Liquid-Prep/LiquidPrep-Hardware/CNM/images/BlueFruitHEX.jpg

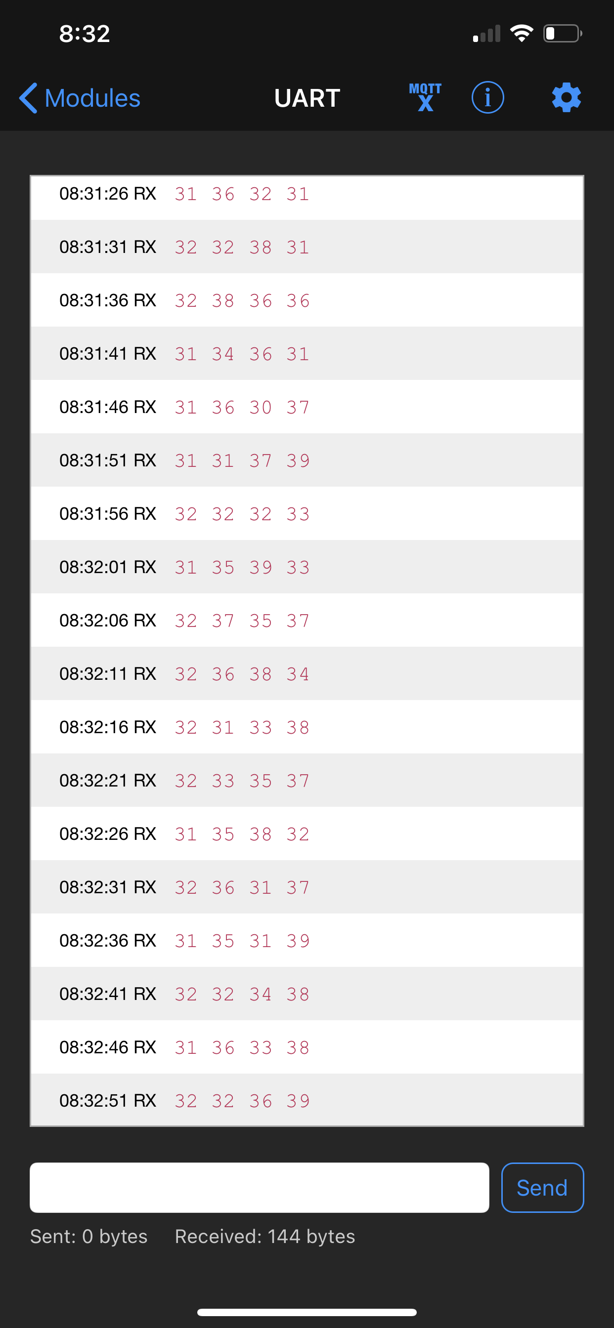
CNM/images/BlueFruitHEX.jpg
