Liquid-Prep/LiquidPrep-Hardware/CNM/images/BluefruitUART.png

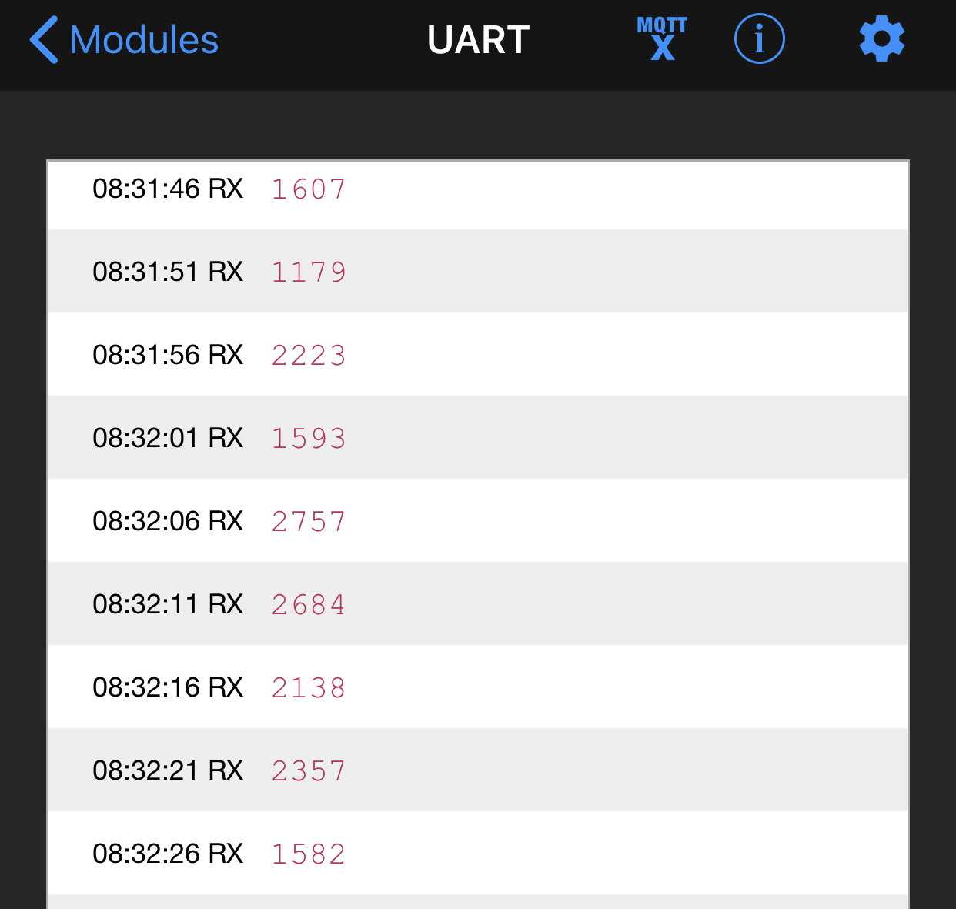
CNM/images/BluefruitUART.png
