Liquid-Prep/LiquidPrep-Hardware/CNM/images/boron.jpg

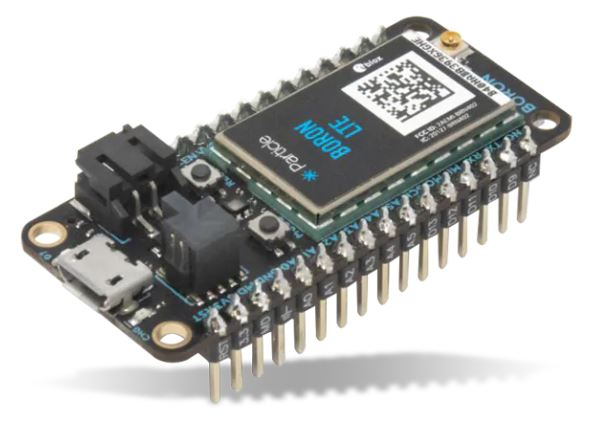
CNM/images/boron.jpg
