Liquid-Prep/LiquidPrep-Hardware/CNM/images/Complie.jpg

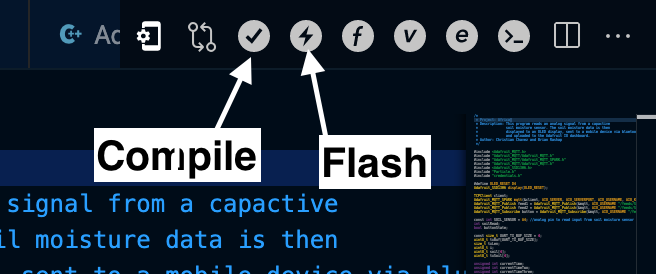
CNM/images/Complie.jpg
