Liquid-Prep/LiquidPrep-Hardware/CNM/images/HardwareLoading.jpg

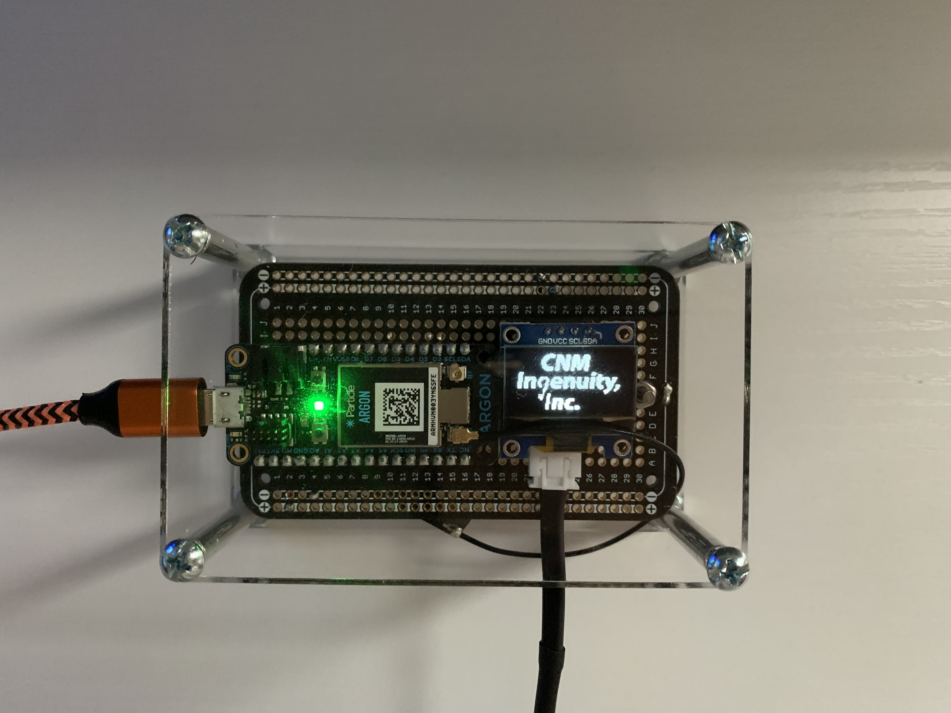
CNM/images/HardwareLoading.jpg
