Liquid-Prep/LiquidPrep-Hardware/CNM/images/MorseCamApp.jpg

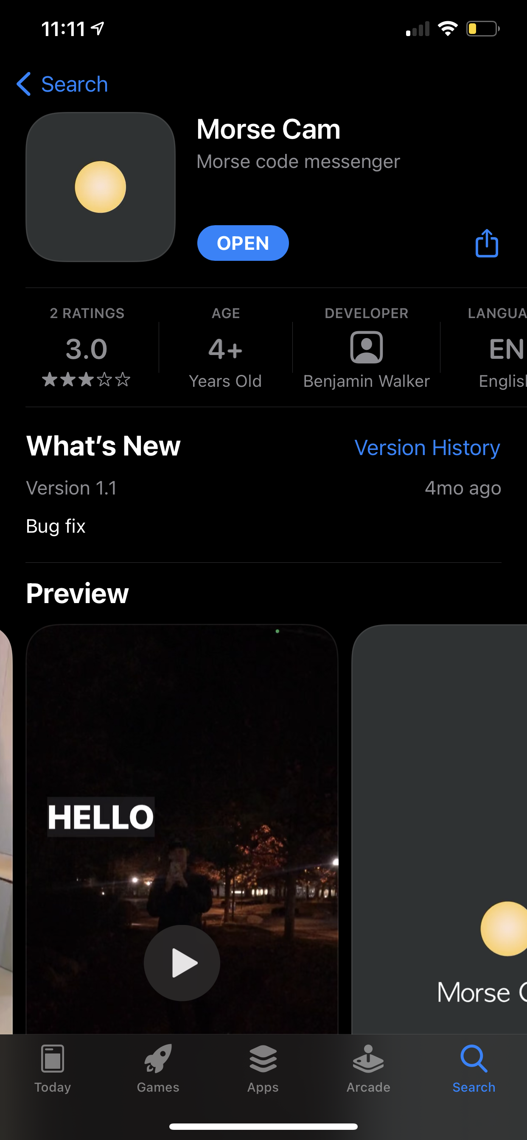
CNM/images/MorseCamApp.jpg
