Liquid-Prep/LiquidPrep-Hardware/CNM/images/ParticleCase.jpg

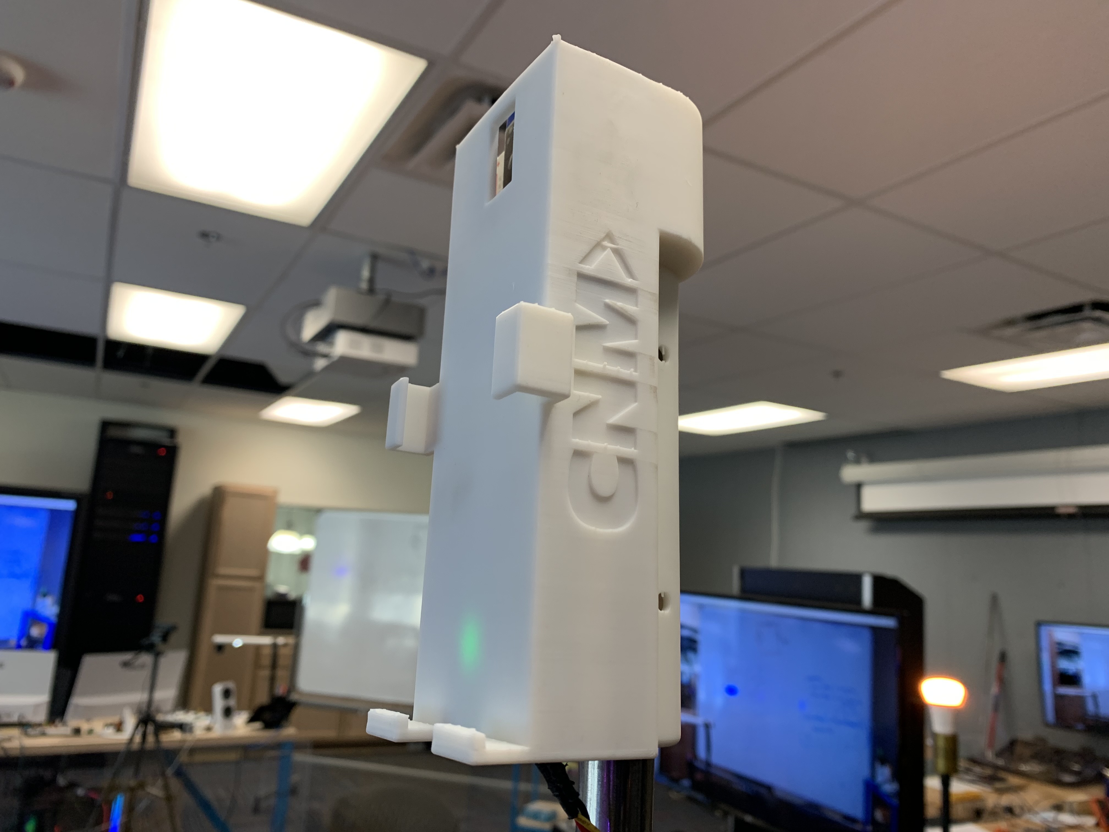
CNM/images/ParticleCase.jpg
