Liquid-Prep/LiquidPrep-Hardware/CNM/images/ProbesWithFuse.jpg

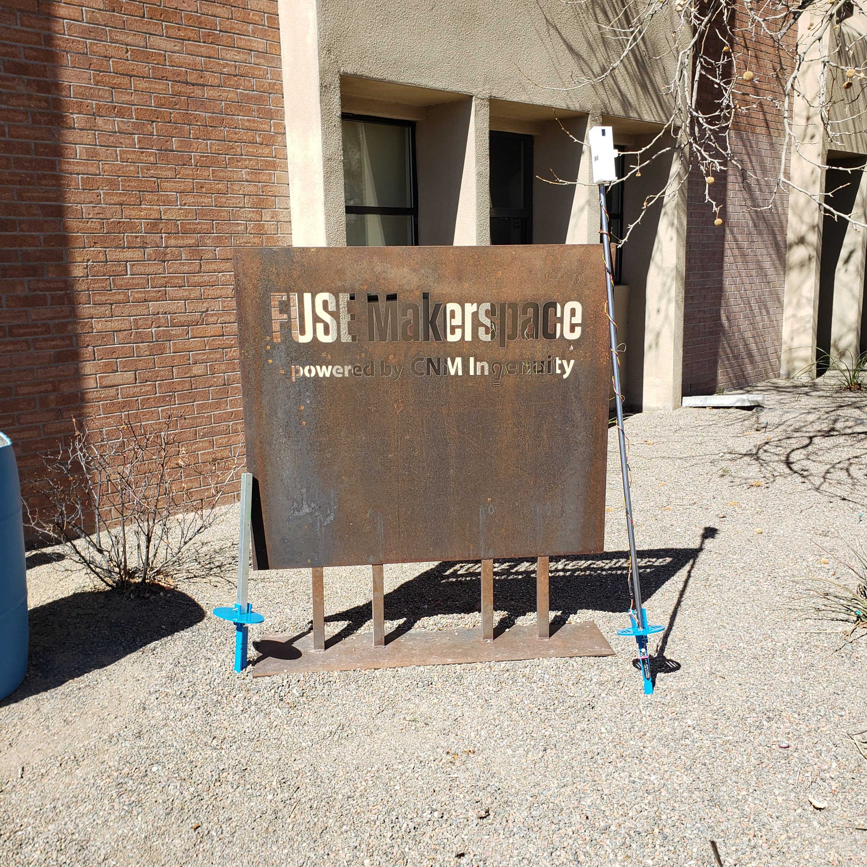
CNM/images/ProbesWithFuse.jpg
