Liquid-Prep/LiquidPrep-Hardware/esp-now/sensors-view.png

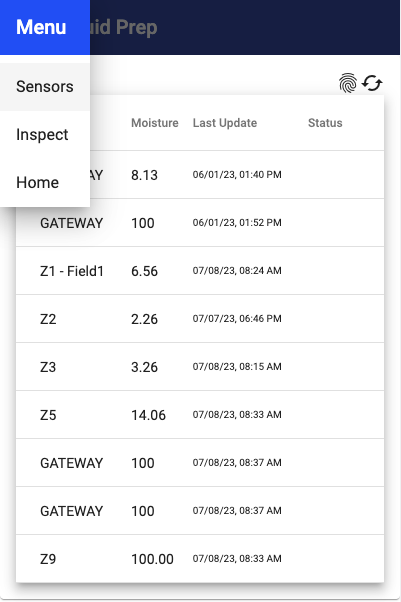
esp-now/sensors-view.png
