Liquid-Prep/LiquidPrep-Hardware/readme-qr.jpg

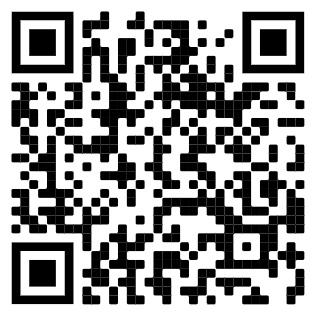
readme-qr.jpg
