Liquid-Prep/LiquidPrep-Hardware/CNM/3D Print/CNMParticleLid.stl

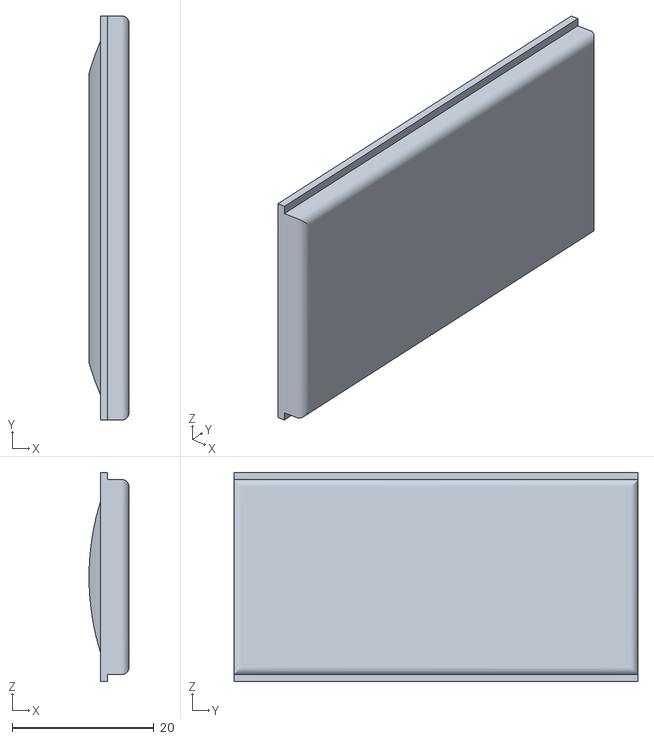
[picture p39: CAD file, 2022-02-01]
CNM/3D Print/CNMParticleLid.stl
5.64 x 57.0 x 29.5
