Liquid-Prep/LiquidPrep-Hardware/CNM/3D Print/CNMParticleCase.stl

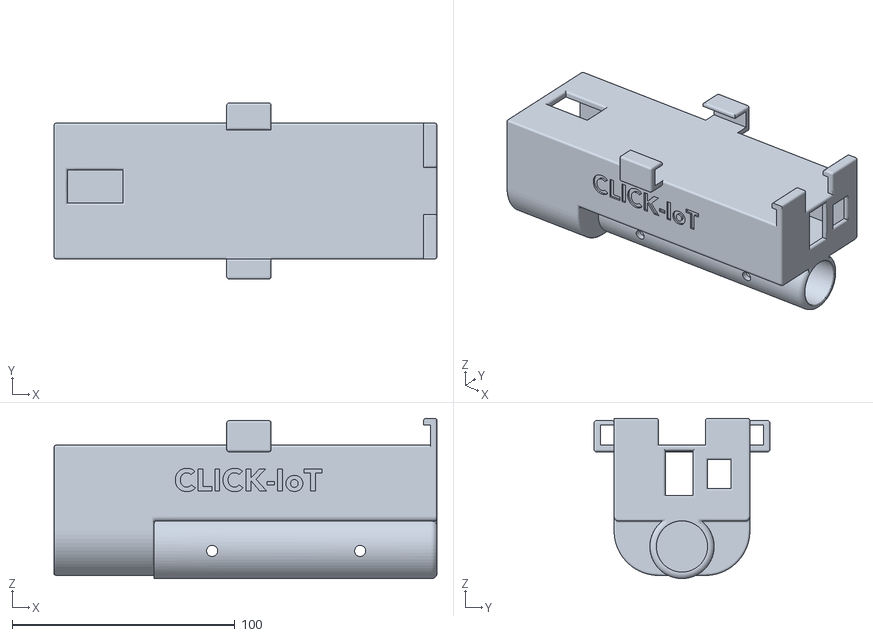
[picture p40: CAD file, 2022-02-01]
CNM/3D Print/CNMParticleCase.stl
172.0 x 79.0 x 71.9
