Liquid-Prep/LiquidPrep-Hardware/esp32-websocket-client/test/notes.txt

#include <ESP8266WiFi.h>
#include <ESP8266WebServer.h>
#include <WebSocketsServer.h>
#include <AutoConnect.h>

ESP8266WebServer server(80);
WebSocketsServer webSocket(81);
AutoConnect      portal(server);
AutoConnectAux   AUX;

void setup() {
  delay(1000);
  Serial.begin(115200);
  Serial.println();

  portal.join({ AUX }); // Join the AutoConnectAux
  if (portal.begin()) { // <--- Should be first.
    webSocket.begin();  // <--- After AutoConnect::begin
    webSocket.onEvent([] (uint8_t num, WStype_t type, uint8_t * payload, size_t length) {
      switch(type) {
      case WStype_DISCONNECTED:
        DEBUG_ESP_PORT.printf("[%u] Disconnected!\n", num);
        break;
      case WStype_CONNECTED: {
        IPAddress ip = webSocket.remoteIP(num);
        DEBUG_ESP_PORT.printf("[%u] Connected from %s\n", num, ip.toString().c_str());
        webSocket.sendTXT(num, "Connected");
        }
        break;
      case WStype_TEXT:
        DEBUG_ESP_PORT.printf("[%u] get Text: %s\n", num, payload);
        // send some response to the client
        // webSocket.sendTXT(num, "message here");
        break;
      }
    });
  }
}

void loop() {
  webSocket.loop();
  portal.handleClient();
}
