Liquid-Prep/LiquidPrep-Hardware/(list of files, drawings)

Other design files:
CNM/Particle Sensor Schematics/CNM Moisture Sensor Fritzing Diagram.fzz
