Liquid-Prep/LiquidPrep-Hardware/Soil Moisture Sensor/src/main.cpp

#include <WebServer.h>
#include <WiFi.h>
#include <WiFiClientSecure.h>
#include <AutoConnect.h>
#include <HTTPClient.h>
#include <Arduino.h>
#include <ArduinoJson.h>
#include <BLEDevice.h>
#include <BLEUtils.h>
#include <BLEServer.h>

#define FIRMWARE_VERSION           "0.2.1";
// See the following for generating UUIDs:
// https://www.uuidgenerator.net/

#define SERVICE_UUID        "4fafc201-1fb5-459e-8fcc-c5c9c331914b"
#define CHARACTERISTIC_UUID "beb5483e-36e1-4688-b7f5-ea07361b26a8"

BLECharacteristic *pCharacteristic;
WebServer Server;
AutoConnect Portal(Server);
AutoConnectConfig Config;
HTTPClient http;
WiFiClientSecure client;
String moistureLevel = "";
int airValue = 3440; //3442;  // enter your max air value here
int waterValue = 1803; //1779;  // enter your water value here
int SensorPin = 32;
int soilMoistureValue = 0;
float soilmoisturepercent=0;
const char* fwVersion = FIRMWARE_VERSION;
StaticJsonDocument<512> doc;

void homePage() {
  String htmlResponse = "";
  String jsonString2 = "";
  char jsonString[300];
  char temp[10];
  unsigned int totalBytes = 0;
  unsigned int usedBytes = 0;
  
  htmlResponse = "<!DOCTYPE html>\
  <html lang=\"en\">\
    <head>\
      <meta charset=\"utf-8\">\
      <meta name=\"viewport\" content=\"width=device-width, initial-scale=1\">\
    </head>\
    <body>\
      <h1>Get moisture reading</h1>\
      <div>\
        <div class=\"moisture_container\">Moisture: </div><br>\
        <button id=\"moisture_button\" class=\"moist\">Get Moisture</button>\
      </div>\
      <h3>Remove wifi</h3>\
      <div>\
        <div class=\"wifi_container\">Wifi: </div><br>\
        <button id=\"wifi_button\" class=\"moist\">Remove Wifi</button>\
      </div>\
      <script src=\"https://ajax.googleapis.com/ajax/libs/jquery/1.11.3/jquery.min.js\"></script>\
      <script>\
        var message;\
        var msg;\
        $('.moist').click(function(e){\
          e.preventDefault();\
          if(e.target.id === 'moisture_button') {\
            msg = 'msg1';\
            message = $('#msg1').val();\
            $.get('/moisture', function(data){\
              $('.moisture_container')[0].innerText = 'Moisture: ' + data + '%';\
              console.log(data);\
            });\
          }\
          else if(e.target.id === 'wifi_button') {\
            $.get('/cancelwifi', function(data){\
              $('.wifi_container')[0].innerText = data;\
              console.log(data);\
            });\
          }\
        });\
      </script>";
  htmlResponse = htmlResponse + "<br></body></html>";
  Server.send ( 200, "text/html", htmlResponse );
}

void calculate() {
  int val = analogRead(SensorPin);  // connect sensor to Analog pin

  // soilmoisturepercent = map(soilMoistureValue, airValue, waterValue, 0, 100);
  int valueMinDiff = abs(val - airValue);
  int maxMinDiff = abs(airValue - waterValue);
  soilmoisturepercent = ((float)valueMinDiff / maxMinDiff) * 100;
 
  char str[8];
  if(soilmoisturepercent < 0) {
    soilmoisturepercent = 0;
  } else if(soilmoisturepercent > 100) {
    soilmoisturepercent = 100;
  }
  Serial.printf("sensor reading: %d - %f%\n", val, soilmoisturepercent);  // print the value to serial port
  dtostrf(soilmoisturepercent, 1, 2, str);
  moistureLevel = str;
  // TODO:  only push value when there is a device connected
  pCharacteristic->setValue(str);  // push the value via bluetooth
//https://community.blynk.cc/t/interesting-esp32-issue-cant-use-analogread-with-wifi-and-or-esp-wifimanager-library/49130
}

void cancelwifi(void) {
  AutoConnectCredential credential;
  station_config_t config;
  uint8_t ent = credential.entries();
  String msg = "";

  Serial.println("AutoConnectCredential deleting");
  if (ent)
    Serial.printf("Available %d entries.\n", ent);
  else {
    Serial.println("No credentials saved.");
    WiFi.disconnect(true, true); // Clear memorized STA configuration
    if (!WiFi.isConnected()) {
      Serial.println("WiFi disconnected");
    }
    Server.send ( 200, "text/html", "WiFi disconnected" );
    return;
  }

  while (ent--) {
    credential.load((int8_t)0, &config);
    if (credential.del((const char*)&config.ssid[0])) {
      Serial.printf("%s deleted.\n", (const char*)config.ssid);
    } else {
      Serial.printf("%s failed to delete.\n", (const char*)config.ssid);
    }  
  }
  WiFi.disconnect(true, true); // Clear memorized STA configuration
  if (!WiFi.isConnected()) {
    Serial.println("WiFi disconnected");
  }
  Server.send ( 200, "text/html", "WiFi disconnected" );
}

void moisture() {
  calculate();
  Server.send ( 200, "text/html", moistureLevel );
}

void moistureJson() {
  calculate();
  String response = "{\"moisture\": " + moistureLevel + "}";
  Server.send( 200, "text/json", response);
}

String onHome(AutoConnectAux& aux, PageArgument& args) {
  calculate();
  Serial.println(moistureLevel);
  aux["results"].as<AutoConnectText>().value = moistureLevel;
  return String();
}
String saveJson() {
  String msg = "";
  File configFile = SPIFFS.open("/config.json", "w+"); 
  if(configFile) {
    serializeJson(doc, configFile);
    msg = "Updated config successfully!";
    configFile.close();
  } else {
    msg = "Failed to open config file for writing!";
    Serial.println(msg);
  }
  return msg;
}

String onSaveConfig(AutoConnectAux& aux, PageArgument& args) {
  airValue = doc["airValue"] = args.arg("airValue").toInt();
  waterValue = doc["waterValue"] = args.arg("waterValue").toInt();
  String msg = saveJson();
  aux["results"].as<AutoConnectText>().value = msg;
  return String();
}

String onUpdateConfig(AutoConnectAux& aux, PageArgument& args) {
  int value = doc["waterValue"];
  Serial.println(value);
  aux["waterValue"].as<AutoConnectInput>().value = value;
  value = doc["airValue"];
  Serial.println(value);
  aux["airValue"].as<AutoConnectInput>().value = value;
  return String();
}

void enableBluetooth() {
    Serial.println("Starting BLE work!");

  BLEDevice::init("ESP32-LiquidPrep");
  BLEServer *pServer = BLEDevice::createServer();
  BLEService *pService = pServer->createService(SERVICE_UUID);
  pCharacteristic = pService->createCharacteristic(
                                         CHARACTERISTIC_UUID,
                                         BLECharacteristic::PROPERTY_READ |
                                         BLECharacteristic::PROPERTY_WRITE
                                       );
  // pCharacteristic->setValue("92");  // use this to hard-code value sent via bluetooth (for testing)
  
  pService->start();
  // BLEAdvertising *pAdvertising = pServer->getAdvertising();  // this still is working for backward compatibility
  BLEAdvertising *pAdvertising = BLEDevice::getAdvertising();
  pAdvertising->addServiceUUID(SERVICE_UUID);
  pAdvertising->setScanResponse(true);
  pAdvertising->setMinPreferred(0x06);  // functions that help with iPhone connections issue
  pAdvertising->setMinPreferred(0x12);
  BLEDevice::startAdvertising();
  Serial.println("Characteristic defined! Now you can read it in your phone!");                                       
}

void setup() {
  delay(1000);
  Serial.begin(115200);
  Serial.println();
  SPIFFS.begin();

  File page = SPIFFS.open("/page.json", "r");
  if(page) {
    Portal.load(page);
    page.close();
  }
  File config = SPIFFS.open("/config.json", "r");
  if(config) {
    DeserializationError error = deserializeJson(doc, config);
    if(error) {
      Serial.println(F("Failed to read file, using default configuration"));
      Serial.println(error.c_str());
    } else {
      airValue = doc["airValue"];
      waterValue = doc["waterValue"];
      SensorPin = doc["pin"]; 
      int pin = doc["pin"];
      Serial.println(pin);
      config.close();
    }
  }

  Config.autoReconnect = true;
  Config.hostName = "liquid-prep";
  Config.ota = AC_OTA_BUILTIN;
  Config.otaExtraCaption = fwVersion;
  Portal.config(Config);
  Portal.on("/update_config", onUpdateConfig);
  Portal.on("/save_config", onSaveConfig);
  Portal.on("/", onHome);
  Portal.begin();

  Server.enableCORS();
  Server.on("/moisture", moisture);
  Server.on("/moisture.json", moistureJson);
  Serial.println("Connecting");
  if (Portal.begin()) {
    Serial.println("WiFi connected: " + WiFi.localIP().toString());
  }
  while(WiFi.status() != WL_CONNECTED) {
    delay(500);
    Serial.print(".");
  }
  enableBluetooth();
}

void loop() {
  Portal.handleClient();
  calculate();
  delay(1000);
}
