Liquid-Prep/LiquidPrep-Hardware/(commit log)

2021-04-01 rename sample config file for app to build successfully in CI
2021-04-01 add proper file path ref for sample config file
2021-04-01 renamed config sample file to successfully rename in ubuntu
2021-08-20 re-organizing sensor device files
2021-08-23 added generic readme for soil sensor setup
2021-10-15 added support for sensor connection via esp32 bluetooth
2022-02-01 move CNM contents into sensor folder
    [CNM Moisture Sensor Fritzing Diagram.fzz, CNMParticleCase.stl, CNMParticleLid.stl]
2022-02-10 organizing sensor files
    [CNM Moisture Sensor Fritzing Diagram.fzz, CNMParticleCase.stl, CNMParticleLid.stl]
2022-09-07 add platformio support
    [partitions_wroom.csv, partitions_wrover.csv]
2022-09-26 update ESP32 setup video link
2022-10-18 update readme, print error
    [main.cpp]
2022-11-11 Update ESP32_BLE_server.ino
    Updated link to Kolban sample.
2023-01-13 add pin to config
2023-01-13 websocket client support
    [partitions_wroom.csv, partitions_wrover.csv]
2023-01-16 revert to upload files
    [main.cpp]
2023-03-08 continue with logics communicating between esp32
2023-03-09 relate sensor readings to express server
2023-03-12 add gitignore and more logic to communicate betweet esp32
2023-03-14 add calibrate air and water values
2023-03-14 add calibrate air and water values and update notes
2023-04-29 fix valid json string
    [common.h]
2023-09-28 Add Stepwise instructions for IoT setup
    **Describe at a high level the solution you're providing**
    - [x] Add Stepwise instructions for setting up moisture sensor and the ESP32.
    **Is this a patch, a minor version change, or a major version change**
    - documentation edit
    **Is this related to an open issue?**
    - [x] This closes the issue [#178](https://github.com/Liquid-Prep/Liquid-Prep/issues/178).
2023-10-10 fix dynamic update name of ble device
    [main.cpp]
